DarkPhoenix889/BaroSense/README.md

## BaroSense
Von Kilian Simma und Raphael Schöffmann
BaroSense_Gehäuse
