DarkPhoenix889/BaroSense/BaroSense_Gehäuse.png

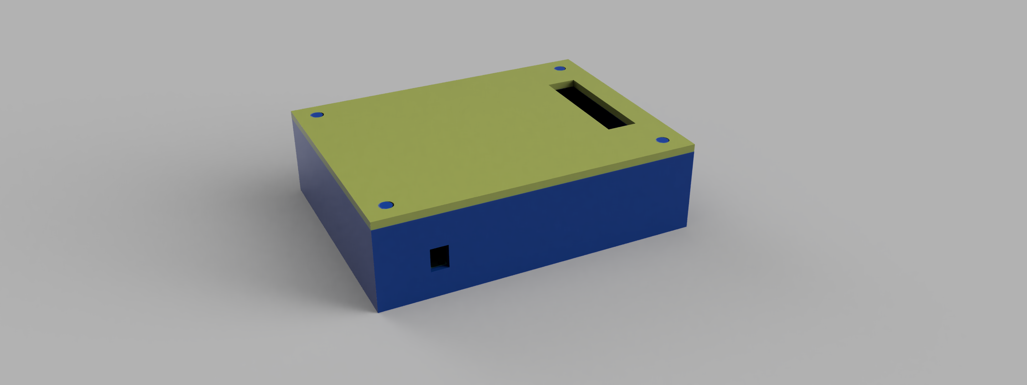
BaroSense_Gehäuse.png
