DarkPhoenix889/BaroSense/Schaltplan_BaroSense.pdf

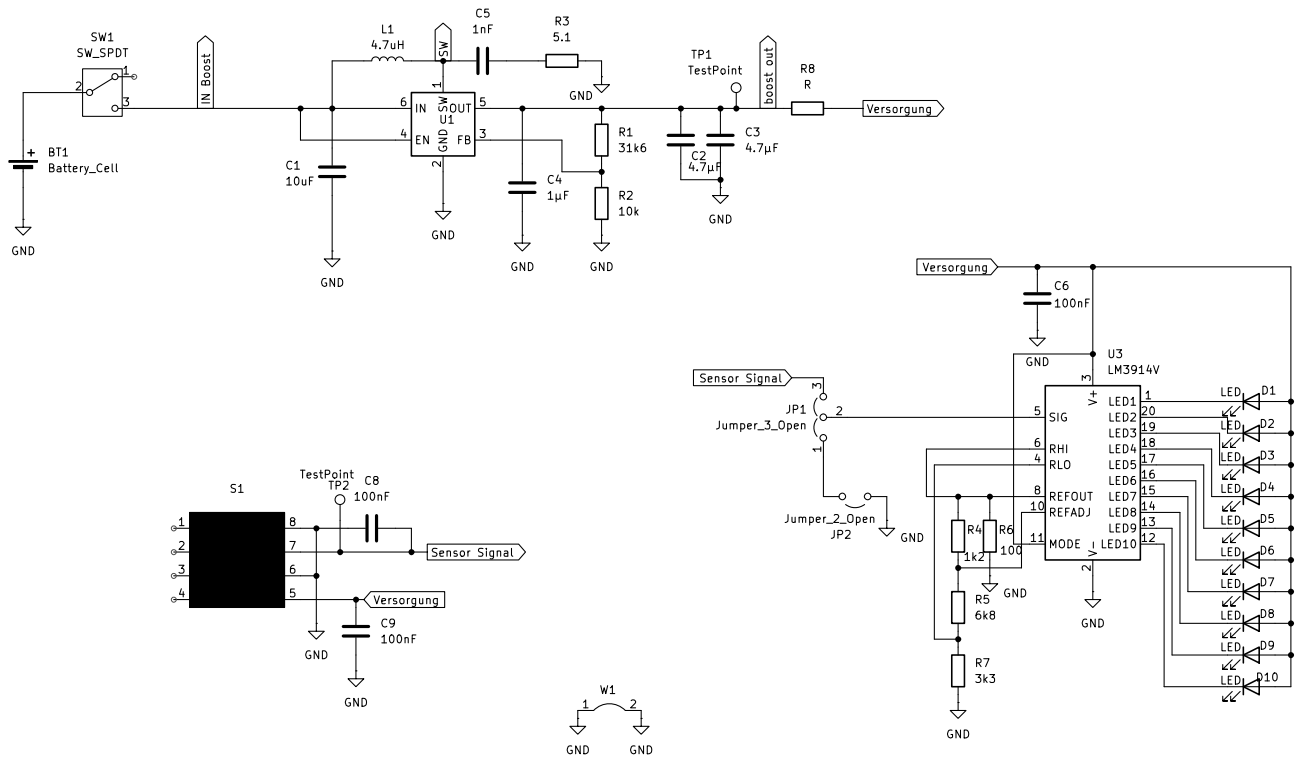
[picture p22: page 1]
