DarkPhoenix889/BaroSense/BaroSense_Simulation.asc

R1: res; 1200
R3: res; 4k7
R5: res; 10k
U1: LT1117
V1: voltage; 5
Named nets: 0
.op
